RCDaddy/T-Box/README.md

# RCD T-Box
The RCD T-Box is a 5.8ghz video reciever based on the schematics and code of [rx5808-pro-diversity](https://github.com/sheaivey/rx5808-pro-diversity) project.

This project was created for people who cannot solder SMT components but are happy to build one themselves.

## Donations Welcome!
Lets be honest, development costs money so any help you can give will be more than appreciated.

**Support the Original RX5808_Pro_Diversity Project by Shea Ivey**



**Support the T-Box Development**



You can find eagle PCB designs and code updates in this repository. You are free to use these designs for personal use only. 

## Table of Contents
1. [Hardware](#hardware)
2. [Eagle Files]- Coming Soon
3. [Enclosure]()
4. [Recognition](#recognition)
5. [License]()

##Hardware
[T-Box v1.1 rev.2](docs/tbox_v1-1.md)

[T-Box v1.0 rev.4](docs/tbox_v1-1.md)

##Eagle Files
Eagle Files and Scematics can be found [here](src/eagle/)

##Enclosure
A basic enclosure has been made and can be found [here](src/enclosure-for-v1.x)

##Recognition
- Diversity Receiver Schematics by Shea Ivey
- Firmware by Shea Ivey
- Original Idea by Marko Hoepken
- Scanner by Johan Hermen
- Initial 2 Button version by Peter (pete1990)

##License
