RCDaddy/T-Box/docs/tbox_v1-0.md

#T-Box v1.0
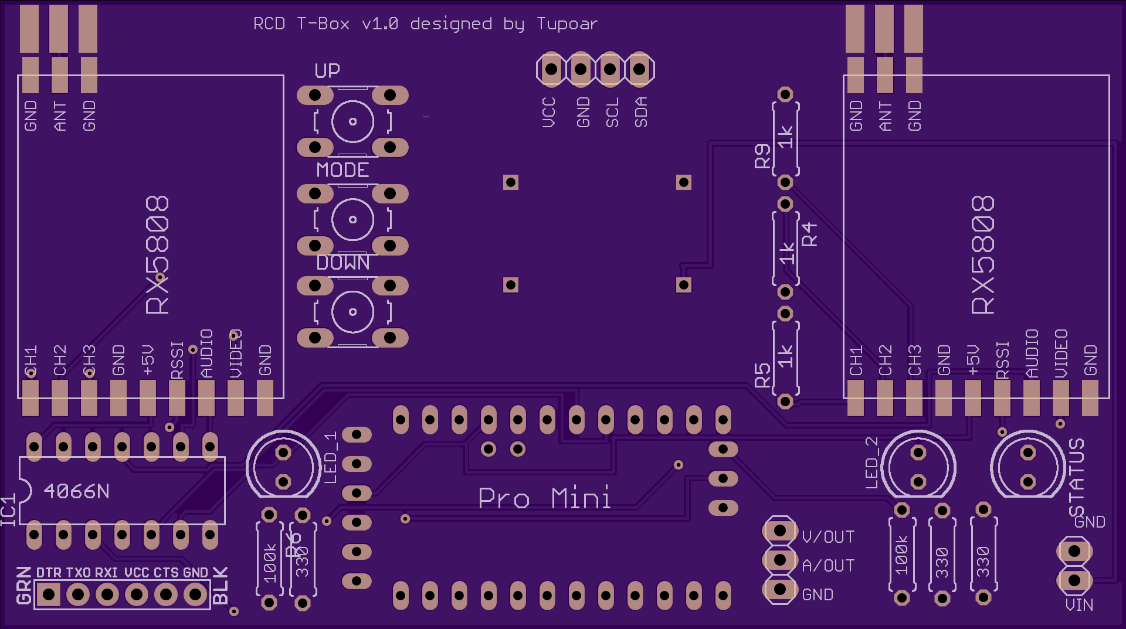
[picture p3: docs/img/v1.0/t-box 1.0 rev4 front.png]

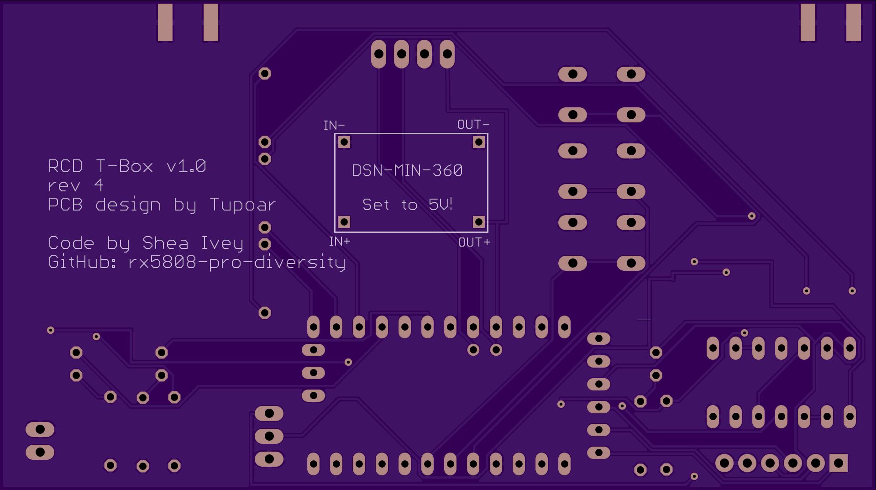
[picture p4: docs/img/v1.0/t-box 1.0 rev4 back.png]


####BOM
- 3x 1k resistor
- 2x 100k resistor
- 3x 330 resistor
- 2x rx5808 receiver with [spi mod](rx5808-spi-mod.md)
- 3x 5mm LEDs
- 3x Miniature Tactile Button
- 1x DSN-MIN-360 Step Down regulator.
- 2x RP-SMA/SMA connector board mountable
- 1x 4066 digital switch chip
- 1x Arduino Pro Mini
- 1x OLED 128x64 display I2C (5v tollerant) Pin order must be VCC GND SCL SDA
