RCDaddy/T-Box/(list of files, cad)

Other CAD files:
src/enclosure-for-v1.x/enclosure v0.21.skp
src/enclosure-for-v1.x/enclosure v0.22.skp
