RCDaddy/T-Box/src/eagle/v1.0/rx5808 vTup 0.4.brd

## EAGLE design src/eagle/v1.0/rx5808 vTup 0.4.brd (2015-10-18, an earlier design)

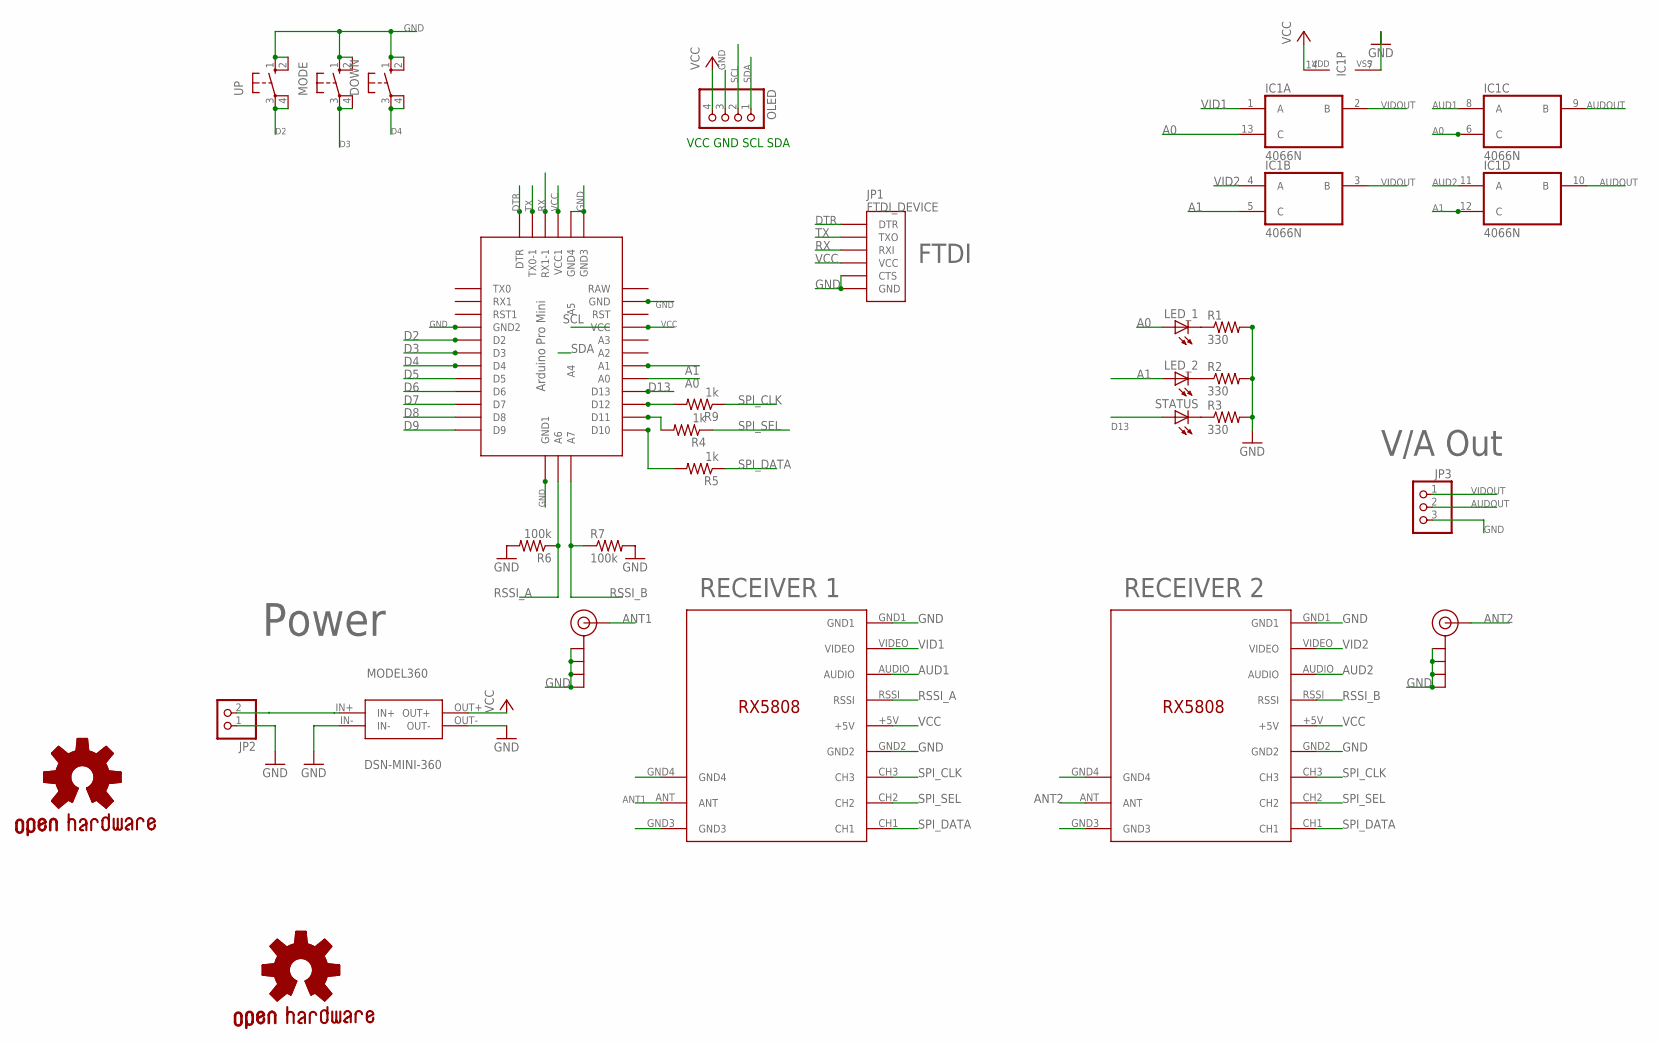
[picture p5: schematic rx5808 vTup 0.4.sch]

Parts:
ANT1, ANT2: SMA_EDGE; SMA-EDGE
DOWN: 10-XX; B3F-10XX
DSN-MINI-360: MODEL360
GOLD_ORB_SM1: OSHWLOGO_GOLD_ORB_LG; OSHW0
GOLD_ORB_SM2: OSHWLOGO_GOLD_ORB_SM; OSHW2
IC1: 4066N; DIL14
JP1: FTDI_DEVICE; FTDI_DEVICE_SIDE
JP2: PINHD-1X2; 1X02
JP3: PINHD-1X3; 1X03
LED_1, LED_2: LED5MM
MODE: 10-XX; B3F-10XX
OLED: PINHD-1X4; 1X04
R1, R2, R3: 330; 0207/7
R4, R5, R9: 1k; 0207/7
R6, R7: 100k; 0207/7
RECEIVER_A: RX5808_A; RX5808
RECEIVER_B: RX5808_B; RX5808
STATUS: LED5MM
U$1: Pro Mini; ABK-PRO-MINI
UP: 10-XX; B3F-10XX

Connections:
A0: IC1.6 (C), IC1.13 (C), LED_1.A, U$1.A0
A1: IC1.5 (C), IC1.12 (C), LED_2.A, U$1.A1
ANT1: ANT1.SIG (SIGNAL), RECEIVER_A.ANT
ANT2: ANT2.SIG (SIGNAL), RECEIVER_B.ANT
AUD1: IC1.8 (A), RECEIVER_A.AUDIO
AUD2: IC1.11 (A), RECEIVER_B.AUDIO
AUDOUT: IC1.9 (B), IC1.10 (B), JP3.2
D2: U$1.D2, UP.3, UP.4 (P1)
D3: MODE.3, MODE.4 (P1), U$1.D3
D4: DOWN.3, DOWN.4 (P1), U$1.D4
D10: R5.2, U$1.D10
D11: R4.2, U$1.D11
D12: R9.2, U$1.D12
D13: STATUS.A, U$1.D13
DTR: JP1.P$1 (DTR), U$1.GND2 (DTR)
GND: ANT1.GND@0 (GND), ANT1.GND@1 (GND), ANT1.GND@2 (GND), ANT1.GND@3 (GND), ANT2.GND@0 (GND), ANT2.GND@1 (GND), ANT2.GND@2 (GND), ANT2.GND@3 (GND), DOWN.1 (S), DOWN.2 (S1), DSN-MINI-360.IN-, DSN-MINI-360.OUT-, IC1.7 (VSS), JP1.P$5 (CTS), JP1.P$6 (GND), JP2.1, JP3.3, MODE.1 (S), MODE.2 (S1), OLED.3, R1.2, R2.2, R3.2, R6.2, R7.2, RECEIVER_A.GND1, RECEIVER_A.GND2, RECEIVER_A.GND3, RECEIVER_A.GND4, RECEIVER_B.GND1, RECEIVER_B.GND2, RECEIVER_B.GND3, RECEIVER_B.GND4, U$1.DTR (GND3), U$1.GND, U$1.GND1 (GND2), U$1.GND4 (GND1), U$1.TX0-1 (GND4), UP.1 (S), UP.2 (S1)
unnamed: LED_1.K (C), R1.1
unnamed: LED_2.K (C), R2.1
unnamed: R3.1, STATUS.K (C)
unnamed: DSN-MINI-360.IN+, JP2.2
RSSI_A: R6.1, RECEIVER_A.RSSI, U$1.A6
RSSI_B: R7.1, RECEIVER_B.RSSI, U$1.A7
RX: JP1.P$3 (RXI), U$1.VCC1 (RX1-1)
SCL: OLED.2, U$1.A5
SDA: OLED.1, U$1.A4
SPI_CLK: R9.1, RECEIVER_A.CH3, RECEIVER_B.CH3
SPI_DATA: R5.1, RECEIVER_A.CH1, RECEIVER_B.CH1
SPI_SEL: R4.1, RECEIVER_A.CH2, RECEIVER_B.CH2
TX: JP1.P$2 (TXO), U$1.GND3 (TX0-1)
VCC: DSN-MINI-360.OUT+, IC1.14 (VDD), JP1.P$4 (VCC), OLED.4, RECEIVER_A.+5V, RECEIVER_B.+5V, U$1.RX1-1 (VCC1), U$1.VCC
VID1: IC1.1 (A), RECEIVER_A.VIDEO
VID2: IC1.4 (A), RECEIVER_B.VIDEO
VIDOUT: IC1.2 (B), IC1.3 (B), JP3.1

Notes on the sheet:
VCC GND SCL SDA
RECEIVER 1
RECEIVER 2
FTDI
Power
V/A Out

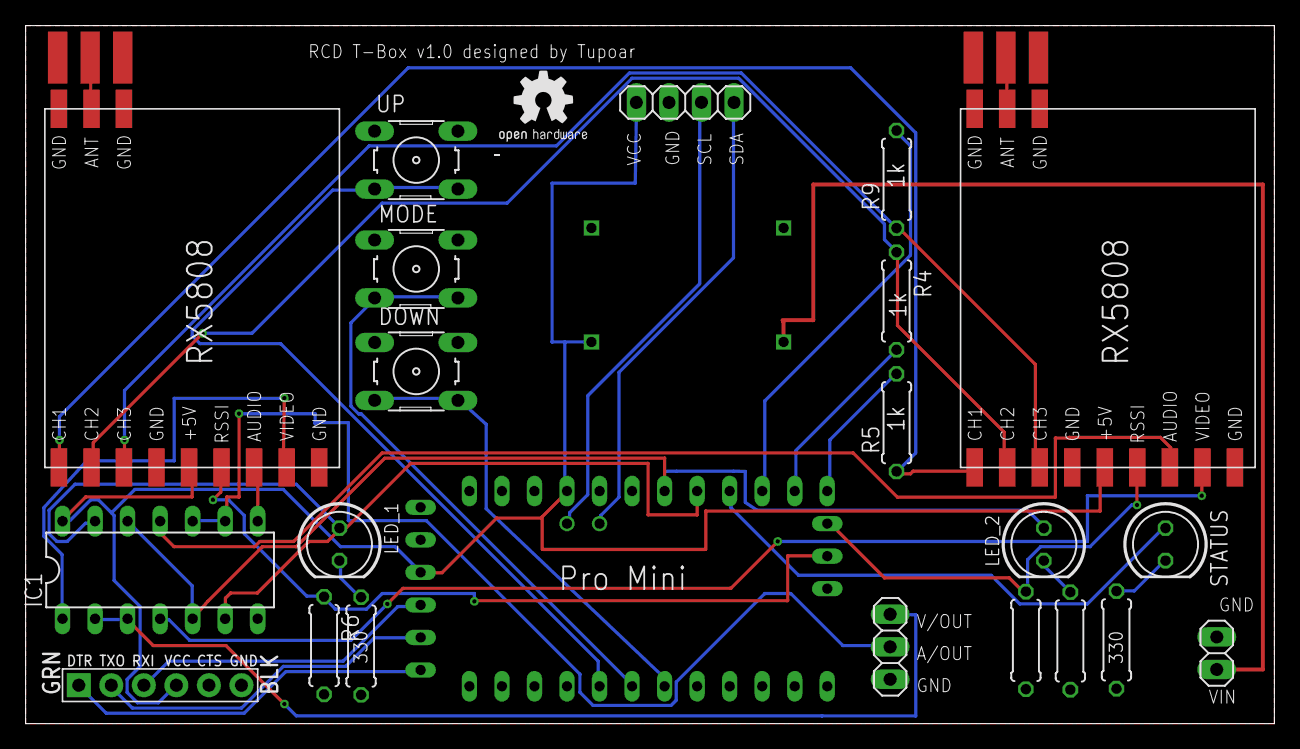
[picture p6: board rx5808 vTup 0.4.brd from above]

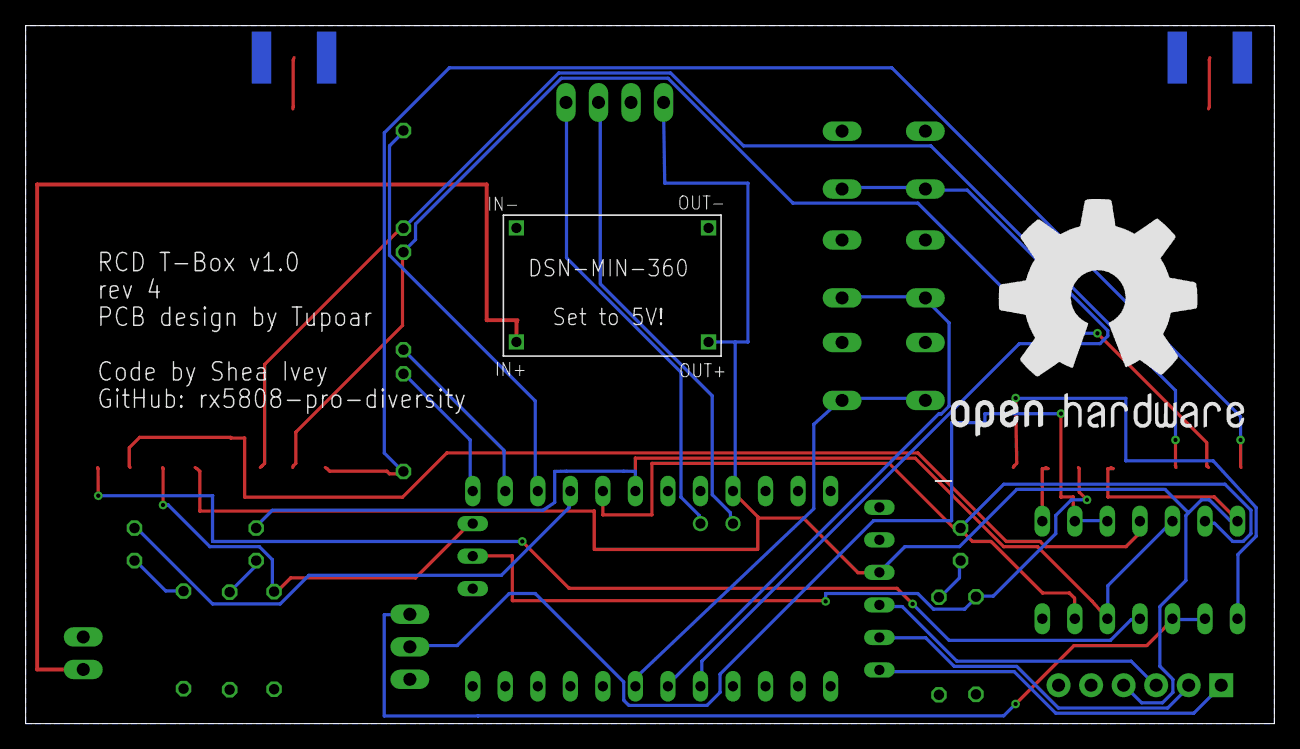
[picture p7: board rx5808 vTup 0.4.brd from below]

Board: 2 copper layers, 97.5 x 54.5 mm, 27 parts (2 on the bottom side), 33 nets.
