RCDaddy/T-Box/docs/changelog T-box v1.1.md

#Changelog T-box v1.1

Rev 2: 
- Fixed missing track between RSSI_A and PIN 25

Rev 1:
- First revision.
