RCDaddy/T-Box/docs/changelog T-box v1.0.md

#Changelog T-box v1.0

Rev 4:

Added 5v regulator to the rear of the board. Requires ‘DSN-MINI-360’ adjustable step down regulator.

More Pro Mini pin corrections

Rev 3.1:

- Minor adjustments to routing
- Minor changes to 100k pull down resistors.

Rev 3:

- Fixed hole spacing for Pro Mini
- Fixed DTR, TX, RX etc ports as they were reversed
- Swapped Up and Down Buttons.
- Added 100K pull down resistors on RSSI lines
- Added extra ground and vcc points for pro mini
- Corrected A5 and A4 conenctions

Rev 2:

- Repositioned via holes

Rev 1:

- Initial version
