RCDaddy/T-Box/(threads)

Thread 4 (2015-10-25):

Upload enclosure files.

RCDaddy, 2015-10-25:
Basic version of enclosure completed and printed. Modifications need. Cut out for OLED needs to be reduced in height. Button holes need to be moved 0.2mm south east.

RCDaddy, 2015-10-26:
files added to 1.1 branch. To merge.

RCDaddy, 2015-10-26:
Update complete and to be pushed with 1.1 files

Closed 2017-05-31.

Thread 7 (2015-10-27):

Edit schematic for TV.

RCDaddy, 2015-10-27:
May require reducing board size, which means a new enclosure.

RCDaddy, 2015-10-28:
Changed milestone to v1.2. will add to current board to give the option of both interfaces.

RCDaddy, 2015-11-03:
Done

Closed 2015-11-03.

Thread 8 (2015-10-27):

Hardware & Eagle files = 404

zanthor, 2015-10-27:
I'm new to this so maybe I'm doing something wrong, but right now if I click on the links I get 404's.

RCDaddy, 2015-10-27:
Yea sorry about that. The Main page is half finished. Will be finished in the next few hours. However, you can find the eagle files the in src/ directory.

RCDaddy, 2015-10-27:
Ok, updated readme.md correcting the link.

zanthor, 2015-10-28:
OK, I'm apparently an idiot because I can't figure out how to add another
issue...  I'm a total GIT newb so I apologize...

I had a set of the v1.0 rev 4 boards made at OSHPark, and I ordered an
arduino pro mini to solder onto it, the 6 pins at the end do not line up,
and I'm not sure if this is intentional and I'm missing something or an
error.. and I can't seem to find the "add new issue" button I found earlier.

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

RCDaddy, 2015-10-28:
It's ok, i'm new to this too!

There are roughly 4-5 variations on the pro mini, each one with the pins laid out slightly differently. The main row of pins should fit perfectly but the others can be worked around by using single core wire.

This is the main reason why i created v1.1.

zanthor, 2015-10-28:
yay! Gotta love standards... the rest of the pins do line up perfectly, and
I happen to have a nice collection of cable which will work nicely to
bridge that gap.

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

Closed 2017-05-31.

Thread 11 (2015-11-20):

Missing track on RSSI_A on 1.1 board.

RCDaddy, 2015-11-20:
Error has been found on the 1.1 board rssi_a connection. Needs correcting in Eagle.

RCDaddy, 2015-11-24:
Modified and created revision 2. Eagle files need updating.

Closed 2017-05-31.

Thread 12 (2016-06-14):

Problem with v1.1 board

idzuwan, 2016-06-14:
Hi,

Sorry I reached out in RCG but no one responded so trying here, my post in rcg

http://www.rcgroups.com/forums/showpost.php?p=35004015&postcount=1368

issues:

1. can't upload via ftdi - resorted to upload via usbsp
2. 4066 chip still making high pitch sound like it going to burst

checked for solder bridges/short etc does not seem so, and my vreg is set to 5v as instructed at T-BOX pcb

todo:

replace atmega - done still the same

next: replace 4066 chip with new one OLED need to be checked if it still working or not

wpvrtis, 2017-06-24:
Hi. I've downloaded the code, and compiled it using Sloeber for Eclipse. I have built the T-Box v1.1.  I got the latest Adafruit SSD1306 librarys and the latest GFX Librarys. I had to fix a fault in pollserial.h. I've got the code to compile and load onto the T-box board using the ftdi. However the screen gets nothing but static.
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
Can someone help me with this? I'm new to Arduino, but i've been doing Java Programming for some time now, and I am familiar with Eclipse.

idzuwan, 2017-09-21:
your issues seem like unsupported OLED latest branch of the code already have the oled support
