RCDaddy/T-Box/(commit log)

2015-10-18 Upload of v 1.0 Eagle Files
    [rx5808 vTup 0.4.brd, rx5808 vTup 0.4.sch]
2015-10-20 Added BOM and file structure tidy up.
2015-10-26 Update to directory structure
    [rx5808 vTup 0.4.brd, rx5808 vTup 0.4.sch]
2015-10-26 Added initial enclosure files
    [Enclosure v0.21.skp, Enclosure v0.21.stl]
2015-10-26 added v1.1 Eagle files
    [rx5808 vTup 1.1.brd, rx5808 vTup 1.1.sch]
2015-10-26 corrected file locations
    [enclosure v0.21.skp, enclosure v0.21.stl]
2015-10-26 tidy up files.
    [enclosure v0.21.stl]
2015-10-27 File update
    [rx5808 vTup 1.1 (restored).brd, rx5808 vTup 1.1 (restored).sch]
2015-10-28 Update to enclosure
    Reduced screen cut out by 5mm
    Increase button hole size by 0.1mm
    [enclosure v0.22.skp]
2015-11-19 Update README.md
    Updated Readme and added donate button.
2015-11-20 Update README.md
    Added donate button for RX5808-Pro-Diversity project.
2015-11-21 Update tbox_v1-1.md
    Changed link to rev 2 board.
